Wudker/Solarbank/Hardware/Photos/image-1791736555270.jpg

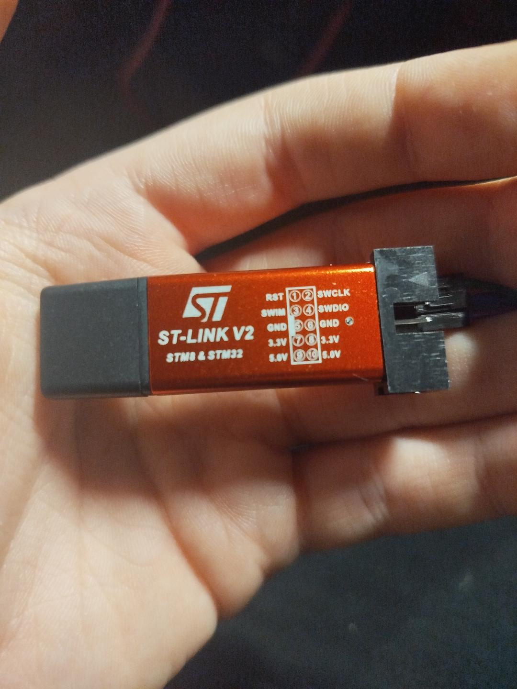
Hardware/Photos/image-1791736555270.jpg
