Wudker/Solarbank/Hardware/PCB/Main.png

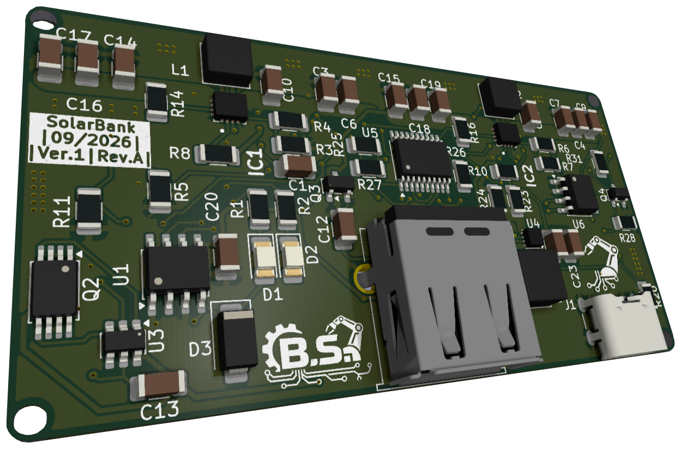
Hardware/PCB/Main.png
