Wudker/Solarbank/Hardware/Model/Main.png

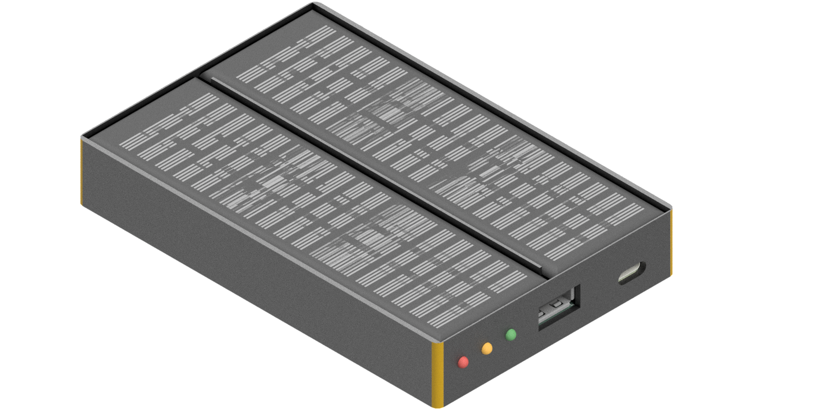
Hardware/Model/Main.png
