Wudker/Solarbank/BOM/BOM.xlsx

Sheet: PCB_BOM
Reference, | Qty | Value | Footprint | Link
C1,C2,C24,C25,C26,C5,C12,C13,C30, | 9 | 100n | Capacitor_SMD:C_1206_3216Metric | https://www.tme.eu/pl/details/cl31b104kbcnnnc/kondensatory-mlcc-smd/samsung/
C3,C4,C6,C7,C9,C21,C22,C23, | 8 | 22u | Capacitor_SMD:C_1206_3216Metric | https://www.tme.eu/pl/details/grm31cr61e226ke15l/kondensatory-mlcc-smd/murata/
C8,C10,C11,C14,C15,C16,C17,C18,C19,C20, | 10 | 10u | Capacitor_SMD:C_1206_3216Metric | https://www.tme.eu/pl/details/cl31a106kahnnne/kondensatory-mlcc-smd/samsung/
C27, | 1 | 4.7u | Capacitor_SMD:C_1206_3216Metric | https://www.tme.eu/pl/details/cl31a475kahnnne/kondensatory-mlcc-smd/samsung/
C28, | 1 | 1u | Capacitor_SMD:C_1206_3216Metric | https://www.tme.eu/pl/details/cl31b105kbhnnne/kondensatory-mlcc-smd/samsung/
C29, | 1 | 10n | Capacitor_SMD:C_1206_3216Metric | https://www.tme.eu/pl/details/cc1206krx7r9bb103/kondensatory-mlcc-smd/yageo/
D1,D2, | 2 | LED | LED_SMD:LED_1206_3216Metric_Pad1.42x1.75mm_HandSolder | https://www.tme.eu/pl/details/of-smd3216r/diody-led-smd-kolorowe/optoflash/
D3,D4, | 2 | SS32 | Diode_SMD:D_SMA | https://www.tme.eu/pl/details/b340a-13-f/diody-schottky-smd/diodes-incorporated
IC1,IC2, | 2 | TPS63070RNMR | KiCad:TPS630701RNMR | https://www.digikey.pl/en/products/detail/texas-instruments/TPS63070RNMR/6217416
J1, | 1 | Alterative_charging | Connector_USB:USB_C_Receptacle_GCT_USB4125-xx-x-0190_6P_TopMnt_Horizontal | https://www.tme.eu/pl/details/usb4125-gf-a-0190/zlacza-usb-i-ieee1394/gct/
J2, | 1 | Vout | Connector_USB:USB_A_Molex_67643_Horizontal | https://www.tme.eu/pl/details/mx-67643-0910/zlacza-usb-i-ieee1394/molex/67643-0910/
L1,L2, | 2 | 1.5uH / XFL4020-152MEC | Inductor_SMD:L_Coilcraft_XAL4020-XXX | https://www.coilcraft.com/en-us/products/power/shielded-inductors/molded-inductor/xfl/xfl4020/?skuId=2392|3785
L3, | 1 | 1u / XEL5030-102 | Inductor_SMD:L_Coilcraft_XAL5030-XXX | https://www.digikey.pl/en/products/detail/texas-instruments/TPS63070RNMR/6217416
Q1,Q3,Q4,Q5, | 4 | 2N7002 | Package_TO_SOT_SMD:SOT-23 | https://www.tme.eu/pl/details/2n7002-dio/tranzystory-z-kanalem-n-smd/diotec-semiconductor/2n7002
Q2, | 1 | 8205A | Package_SO:TSSOP-8_4.4x3mm_P0.65mm | https://pl.aliexpress.com/item/1005006168808626.html
Q6, | 1 | DMP3099L | Package_TO_SOT_SMD:SOT-23 | https://www.tme.eu/pl/details/dmp3099l-7/tranzystory-z-kanalem-p-smd/diodes-incorporated/
R1,R2,R17, | 3 | 1k | Resistor_SMD:R_1206_3216Metric | https://www.tme.eu/pl/details/smd1206-1k-1%25/rezystory-smd/royalohm/1206s4f1001t5e/
R3, | 1 | 680k | Resistor_SMD:R_1206_3216Metric | https://www.tme.eu/pl/details/rc1206fr-07680kl/rezystory-smd/yageo/?expanded=true
R4, | 1 | 130k | Resistor_SMD:R_1206_3216Metric | https://www.tme.eu/pl/details/smd1206-130k/rezystory-smd/royalohm/1206s4j0134t5e/
R5,R11,R14,R16,R22,R28,R29,R30, | 8 | 10k | Resistor_SMD:R_1206_3216Metric | https://www.tme.eu/pl/details/rc1206fr-0710k/rezystory-smd/yageo/rc1206fr-0710kl/
R6, | 1 | 470k | Resistor_SMD:R_1206_3216Metric | https://www.tme.eu/pl/details/rc1206fr-07470k/rezystory-smd/yageo/rc1206fr-07470kl/
R7, | 1 | 150k | Resistor_SMD:R_1206_3216Metric | https://www.tme.eu/pl/details/wr12x1503ftl/rezystory-smd/walsin/
R8,R10,R24, | 3 | 100k | Resistor_SMD:R_1206_3216Metric | https://www.tme.eu/pl/details/smd1206-100k/rezystory-smd/royalohm/1206s4j0104t5e/
R9, | 1 | 1.5k | Resistor_SMD:R_1206_3216Metric | https://www.tme.eu/pl/details/rc1206fr-071k5/rezystory-smd/yageo/rc1206fr-071k5l/
R12, | 1 | 220k | Resistor_SMD:R_1206_3216Metric | https://www.tme.eu/pl/details/rc1206fr-07220kl/rezystory-smd/yageo/
R13, | 1 | 330k | Resistor_SMD:R_1206_3216Metric | https://www.tme.eu/pl/details/rc1206fr-07330kl/rezystory-smd/yageo/
R15, | 1 | 100 | Resistor_SMD:R_1206_3216Metric | https://www.tme.eu/pl/details/rc1206fr-07100r/rezystory-smd/yageo/rc1206fr-07100rl/
R18,R21, | 2 | 5.1k | Resistor_SMD:R_1206_3216Metric | https://www.tme.eu/pl/details/crcw12065k10fktabc/rezystory-smd/vishay/
R19, | 1 | 22k | Resistor_SMD:R_1206_3216Metric | https://www.tme.eu/pl/details/rc1206fr-0722k/rezystory-smd/yageo/rc1206fr-0722kl/
R20, | 1 | 33k | Resistor_SMD:R_1206_3216Metric | https://www.tme.eu/pl/details/wr12x3302ftl/rezystory-smd/walsin/
R23, | 1 | 732k | Resistor_SMD:R_1206_3216Metric
R25,R26,R27, | 3 | 4.7k | Resistor_SMD:R_1206_3216Metric | https://www.tme.eu/pl/details/rc1206fr-074k7/rezystory-smd/yageo/rc1206fr-074k7l/
R31, | 1 | 0.05 | Resistor_SMD:R_1206_3216Metric | https://www.tme.eu/pl/details/mbr1206b5fr050s/rezystory-smd/wayon/
U1, | 1 | TP4056-42-ESOP8 | Package_SO:SOIC-8-1EP_3.9x4.9mm_P1.27mm_EP2.41x3.3mm_ThermalVias | https://allegro.pl/produkt/tp4056-4056-4056e-sop-8-5v-1a-battery-charge-controller-9f4e096b-2b10-4130-90a1-40e4469a7fbb?offerId=17285593534
U2, | 1 | MCP4018-10k | Package_TO_SOT_SMD:SOT-363_SC-70-6 | https://www.mouser.pl/pl/ProductDetail/Microchip-Technology/MCP4018T-103E-LTY?qs=savM97goi5hGuILh2wIQ1w%3D%3D
U3, | 1 | DW01A | Package_TO_SOT_SMD:SOT-23-6 | https://pl.aliexpress.com/item/1005006168808626.html
U4, | 1 | TPS61022 | Package_DFN_QFN:Texas_RWU0007A_VQFN-7_2x2mm_P0.5mm | https://www.mouser.pl/pl/ProductDetail/Texas-Instruments/TPS61022RWUT?qs=vLWxofP3U2xU7G%2FuAQNIxA%3D%3D
U5, | 1 | STM32U031F8Px | Package_SO:TSSOP-20_4.4x6.5mm_P0.65mm | https://www.tme.eu/pl/details/stm32u031f8p6/mikrokontrolery-st/stmicroelectronics/
U6, | 1 | INA219AxD | Package_SO:SOIC-8_3.9x4.9mm_P1.27mm | https://www.tme.eu/pl/details/ina219aidr/wzmacniacze-operacyjne-smd/texas-instruments/

Sheet: Other_elements
Name | Qty | Link
Indicators LED
Greeen | 1 | https://www.tme.eu/pl/details/ltl17kcgm4j/diody-led-tht-okragle/liteon/
Orange | 1 | https://www.tme.eu/pl/details/oso5ja3162a/diody-led-tht-okragle/optosupply/
Red | 1 | https://www.tme.eu/pl/details/osr5ja3162a/diody-led-tht-okragle/optosupply/
Button | 1 | https://www.tme.eu/pl/details/tact-67n-f/mikroprzelaczniki-tact/ninigi/
Fotopanels | 2 | https://sklep.msalamon.pl/produkt/panel-sloneczny-120x38mm-6v-100ma-06w/
Cell | 1 | https://botland.com.pl/akumulatory-li-pol-1s-37v/15643-akumulator-li-pol-akyga-3500mah-1s-37v-zlacze-jst-bec-gniazdo-68x55x6mm-5904422324438.html
M2 heatset inserts & bolts | 4 | https://www.ruthex.de/en/products/ruthex-gewindeeinsatz-m2-70-stuck-rx-m2x4-messing-gewindebuchsen
 |  | https://rc-team.pl/wszystkie-czesci-maverick/144486-maverick-sruby-m2x15mm-countersunk-screw-5700135347456-534745.html
