Wudker/Solarbank/BOM/TME_ORDER.csv

Symbol klienta | Symbol | Oznaczenie producenta | Producent | Ilość | Jednostka | Cena netto | Cena brutto | Wartość netto | Wartość brutto | Waluta
 | CL21B105KAFNNNE | CL21B105KAFNNNE | SAMSUNG | 10 | szt | 0.26 | 0.3199 | 2.6 | 3.2 | PLN
 | B340A-13-F | B340A-13-F | DIODES INCORPORATED | 2 | szt | 1.93 | 2.3727 | 3.86 | 4.75 | PLN
 | USB4125-GF-A-0190 | USB4125-GF-A-0190 | GCT | 2 | szt | 2.155 | 2.6507 | 4.31 | 5.3 | PLN
 | 2N7002-DIO | 2N7002 | DIOTEC SEMICONDUCTOR | 10 | szt | 0.31 | 0.3806 | 3.1 | 3.81 | PLN
 | DMP3099L-7 | DMP3099L-7 | DIODES INCORPORATED | 10 | szt | 0.815 | 1.002 | 8.15 | 10.02 | PLN
 | RC1206JR-07680K | RC1206JR-07680KL | YAGEO | 10 | szt | 0.027 | 0.03284 | 0.27 | 0.33 | PLN
 | SMD1206-130K | 1206S4J0134T5E | ROYALOHM | 100 | szt | 0.045 | 0.05535 | 4.5 | 5.54 | PLN
 | RC1206FR-07470K | RC1206FR-07470KL | YAGEO | 5 | szt | 0.37 | 0.4535 | 1.85 | 2.27 | PLN
 | WR12X1503FTL | WR12X1503FTL | WALSIN | 10 | szt | 0.106 | 0.12967 | 1.06 | 1.3 | PLN
 | SMD1206-100K | 1206S4J0104T5E | ROYALOHM | 100 | szt | 0.065 | 0.07993 | 6.5 | 7.99 | PLN
 | INA219AIDR | INA219AIDR | TEXAS INSTRUMENTS | 2 | szt | 6.55 | 8.0565 | 13.1 | 16.11 | PLN
 | STM32U031F8P6 | STM32U031F8P6 | STMicroelectronics | 2 | szt | 9.115 | 11.2176 | 18.23 | 22.44 | PLN
 | MBR1206B5FR050S | MBR1206B5FR050S | WAYON | 5 | szt | 0.43 | 0.5282 | 2.15 | 2.64 | PLN
 | WR12X3302FTL | WR12X3302FTL | WALSIN | 5 | szt | 0.31 | 0.38212 | 1.55 | 1.91 | PLN
 | RC1206FR-0722K | RC1206FR-0722KL | YAGEO | 10 | szt | 0.056 | 0.06908 | 0.56 | 0.69 | PLN
 | RC1206FR-07100R | RC1206FR-07100RL | YAGEO | 10 | szt | 0.048 | 0.05904 | 0.48 | 0.59 | PLN
 | RC1206FR-07330KL | RC1206FR-07330KL | YAGEO | 10 | szt | 0.048 | 0.05871 | 0.48 | 0.59 | PLN
 | RC1206FR-07220KL | RC1206FR-07220KL | YAGEO | 10 | szt | 0.064 | 0.07921 | 0.64 | 0.79 | PLN
 | RC1206FR-071K5 | RC1206FR-071K5L | YAGEO | 10 | szt | 0.067 | 0.08157 | 0.67 | 0.82 | PLN
 | OSO5JA3162A | OSO5JA3162A | OPTOSUPPLY | 5 | szt | 0.65 | 0.7993 | 3.25 | 4 | PLN
 | LTL17KCGM4J | LTL17KCGM4J | LITEON | 3 | szt | 1.0633 | 1.3075 | 3.19 | 3.92 | PLN
