Wudker/Solarbank/Hardware/Model/SLT/Bottom.stl

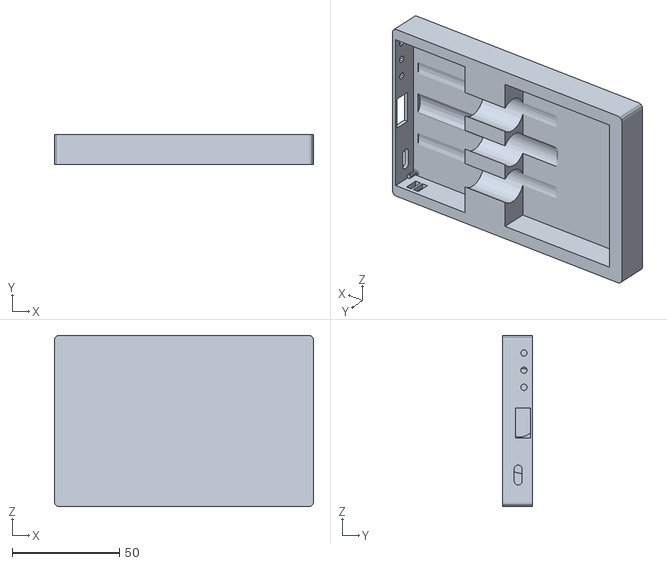
[picture p4: CAD file, 2026-09-20]
Hardware/Model/SLT/Bottom.stl
121.0 x 14.0 x 80.0
