Wudker/Solarbank/Hardware/Model/Parts/OscarML_Led 3mm Rojo v1.step

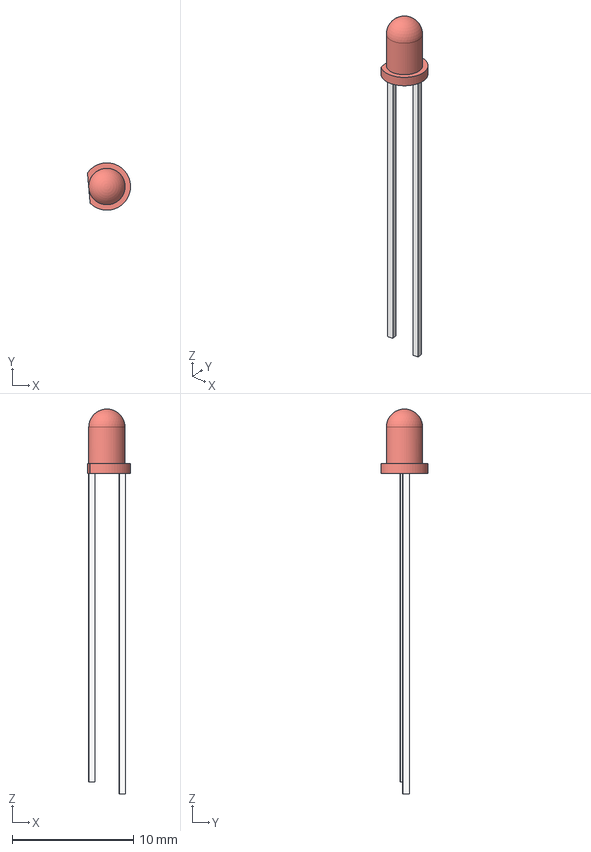
[picture p5: CAD file, 2026-09-19]
Hardware/Model/Parts/OscarML_Led 3mm Rojo v1.step
3.55 x 3.90 x 31.7 mm
