Wudker/Solarbank/Hardware/Model/Parts/SolarPanel_30x65x3mm.step

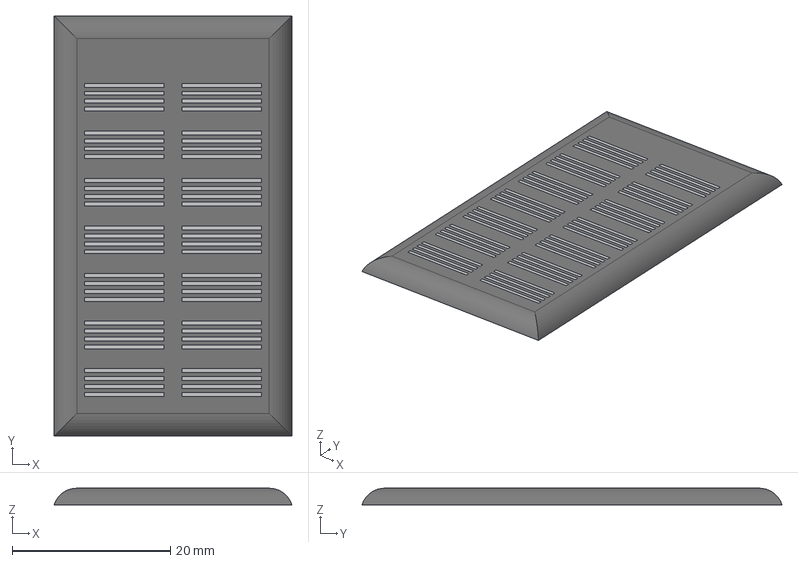
[picture p6: CAD file, 2026-09-19]
Hardware/Model/Parts/SolarPanel_30x65x3mm.step
30.0 x 53.0 x 2.10 mm
