Wudker/Solarbank/Hardware/Model/Parts/Micro_Button_6x6.STEP

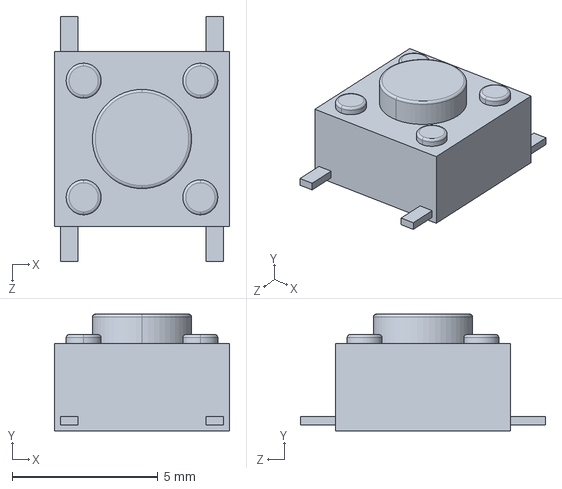
[picture p7: CAD file, 2026-09-19]
Hardware/Model/Parts/Micro_Button_6x6.STEP
6.00 x 4.00 x 8.40 mm
