Wudker/Solarbank/Hardware/Model/Parts/led 3 mm amarillo.step

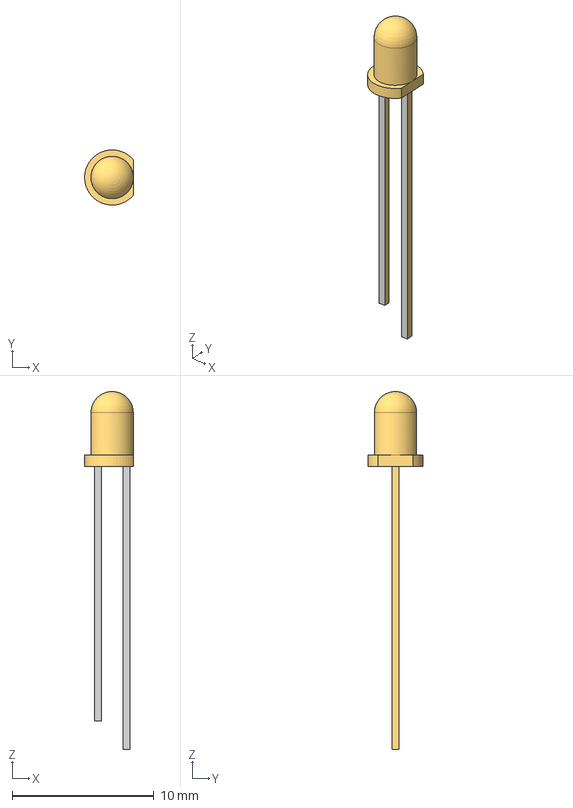
[picture p8: CAD file, 2026-09-19]
Hardware/Model/Parts/led 3 mm amarillo.step
3.45 x 3.90 x 25.3 mm
