Wudker/Solarbank/Hardware/Model/Parts/94459A767_Heat-Set Inserts for Plastic.STEP

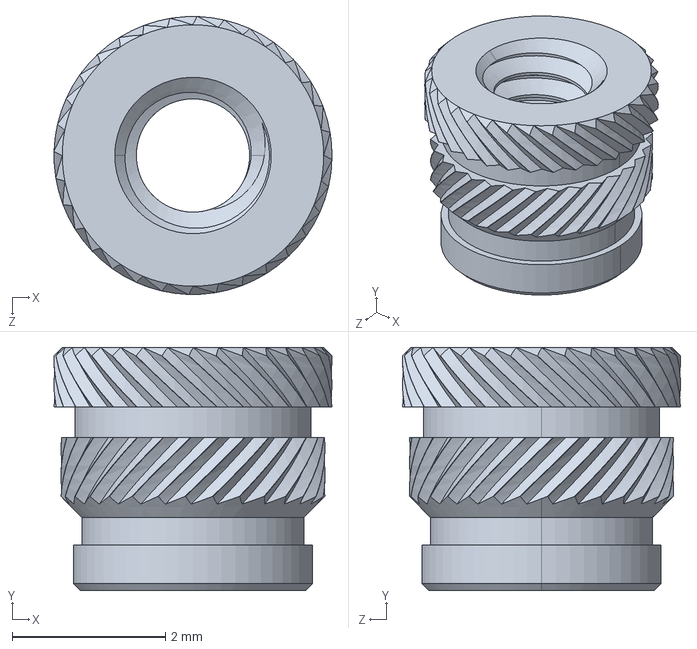
[picture p9: CAD file, 2026-09-20]
Hardware/Model/Parts/94459A767_Heat-Set Inserts for Plastic.STEP
3.63 x 3.18 x 3.63 mm
