Wudker/Solarbank/Hardware/PCB/Power_bank_PCB/TPS61022RWUR/3D/TPS61022RWUR.stp

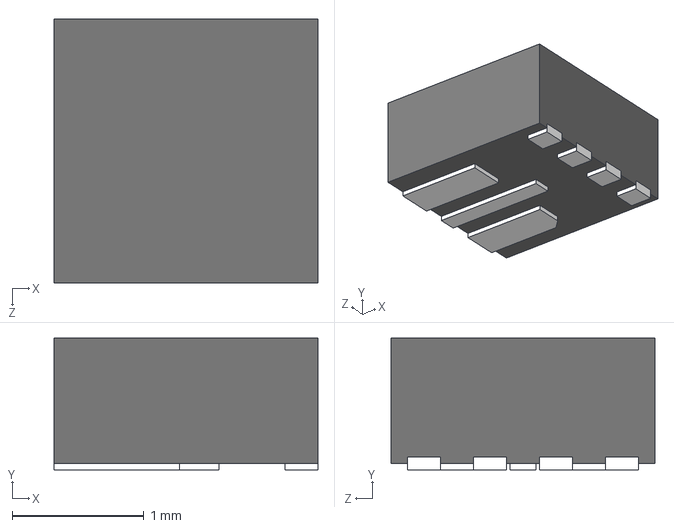
[picture p10: CAD file, 2026-09-09]
Hardware/PCB/Power_bank_PCB/TPS61022RWUR/3D/TPS61022RWUR.stp
2.00 x 1.00 x 2.00 mm
