Wudker/Solarbank/Hardware/PCB/Power_bank_PCB/TPS63070RNMR/3D/TPS63070RNMR.stp

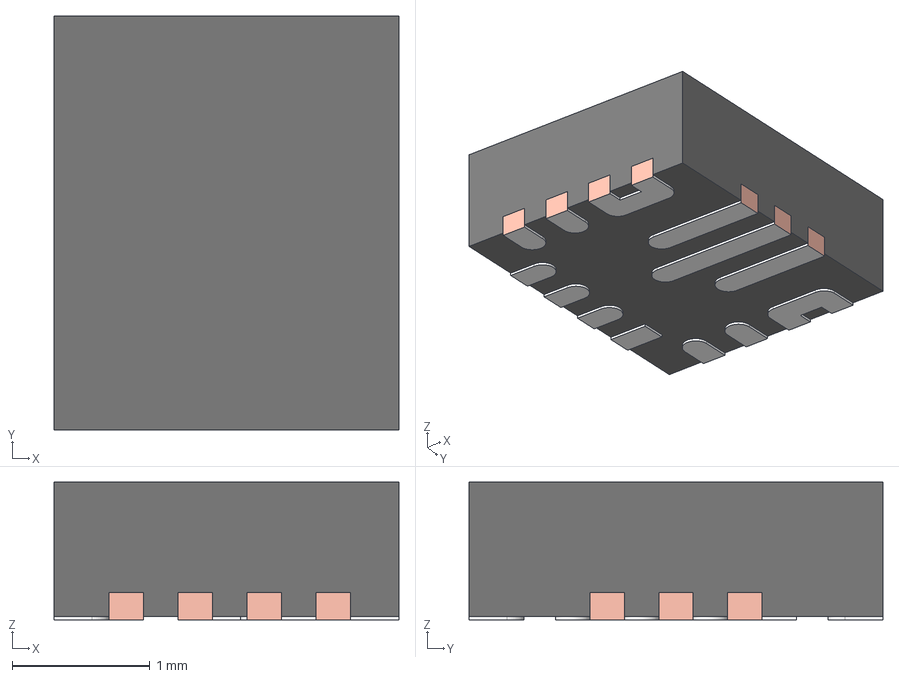
[picture p11: CAD file, 2026-09-02]
Hardware/PCB/Power_bank_PCB/TPS63070RNMR/3D/TPS63070RNMR.stp
2.50 x 3.00 x 1.00 mm
FRAME-RNM0015A
BODY-QFN
PIN1-ID
