Wudker/Solarbank/Hardware/Model/Parts/92000A022_Passivated 18-8 Stainless Steel Pan Head Phillips Screws.STEP

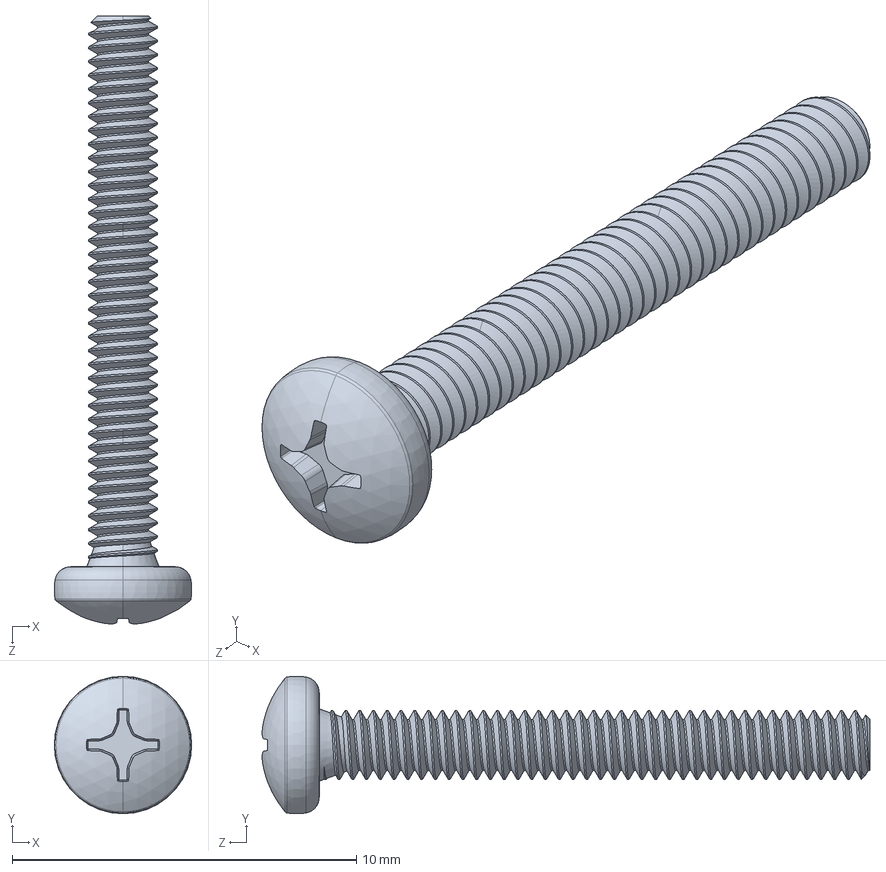
[picture p12: CAD file, 2026-09-20]
Hardware/Model/Parts/92000A022_Passivated 18-8 Stainless Steel Pan Head Phillips Screws.STEP
3.99 x 3.99 x 17.7 mm
