Wudker/Solarbank/(list of files, cad)

Other CAD files:
Hardware/Model/Parts/OscarML_Led 3mm Verde.step
Hardware/Model/Main.iam
Hardware/Model/Parts/92000A022_Passivated 18-8 Stainless Steel Pan Head Phillips Screws/92000A022_Passivated 18-8 Stainless Steel Pan Head Phillips Screws.ipt
Hardware/Model/Parts/94459A767_Heat-Set Inserts for Plastic/94459A767_Heat-Set Inserts for Plastic.ipt
Hardware/Model/Parts/Battery_prop.ipt
Hardware/Model/Parts/Bottom.ipt
Hardware/Model/Parts/Micro_Button_6x6/Micro_Button_6x6.ipt
Hardware/Model/Parts/OscarML_Led 3mm Rojo v1/OscarML_Led 3mm Rojo v1.ipt
Hardware/Model/Parts/OscarML_Led 3mm Verde/OscarML_Led 3mm Verde.ipt
Hardware/Model/Parts/SolarPanel_30x65x3mm/SolarPanel_30x65x3mm.ipt
Hardware/Model/Parts/Top_part.ipt
Hardware/Model/Parts/led 3 mm amarillo/led 3 mm amarillo.ipt
Hardware/PCB/Power_bank_PCB/PCB/PCB/PCB.ipt
