Wudker/Solarbank/Hardware/PCB/Power_bank_PCB/Power_bank_PCB.kicad_pcb

## KiCad design Hardware/PCB/Power_bank_PCB/Power_bank_PCB.kicad_pcb (2026-09-09)

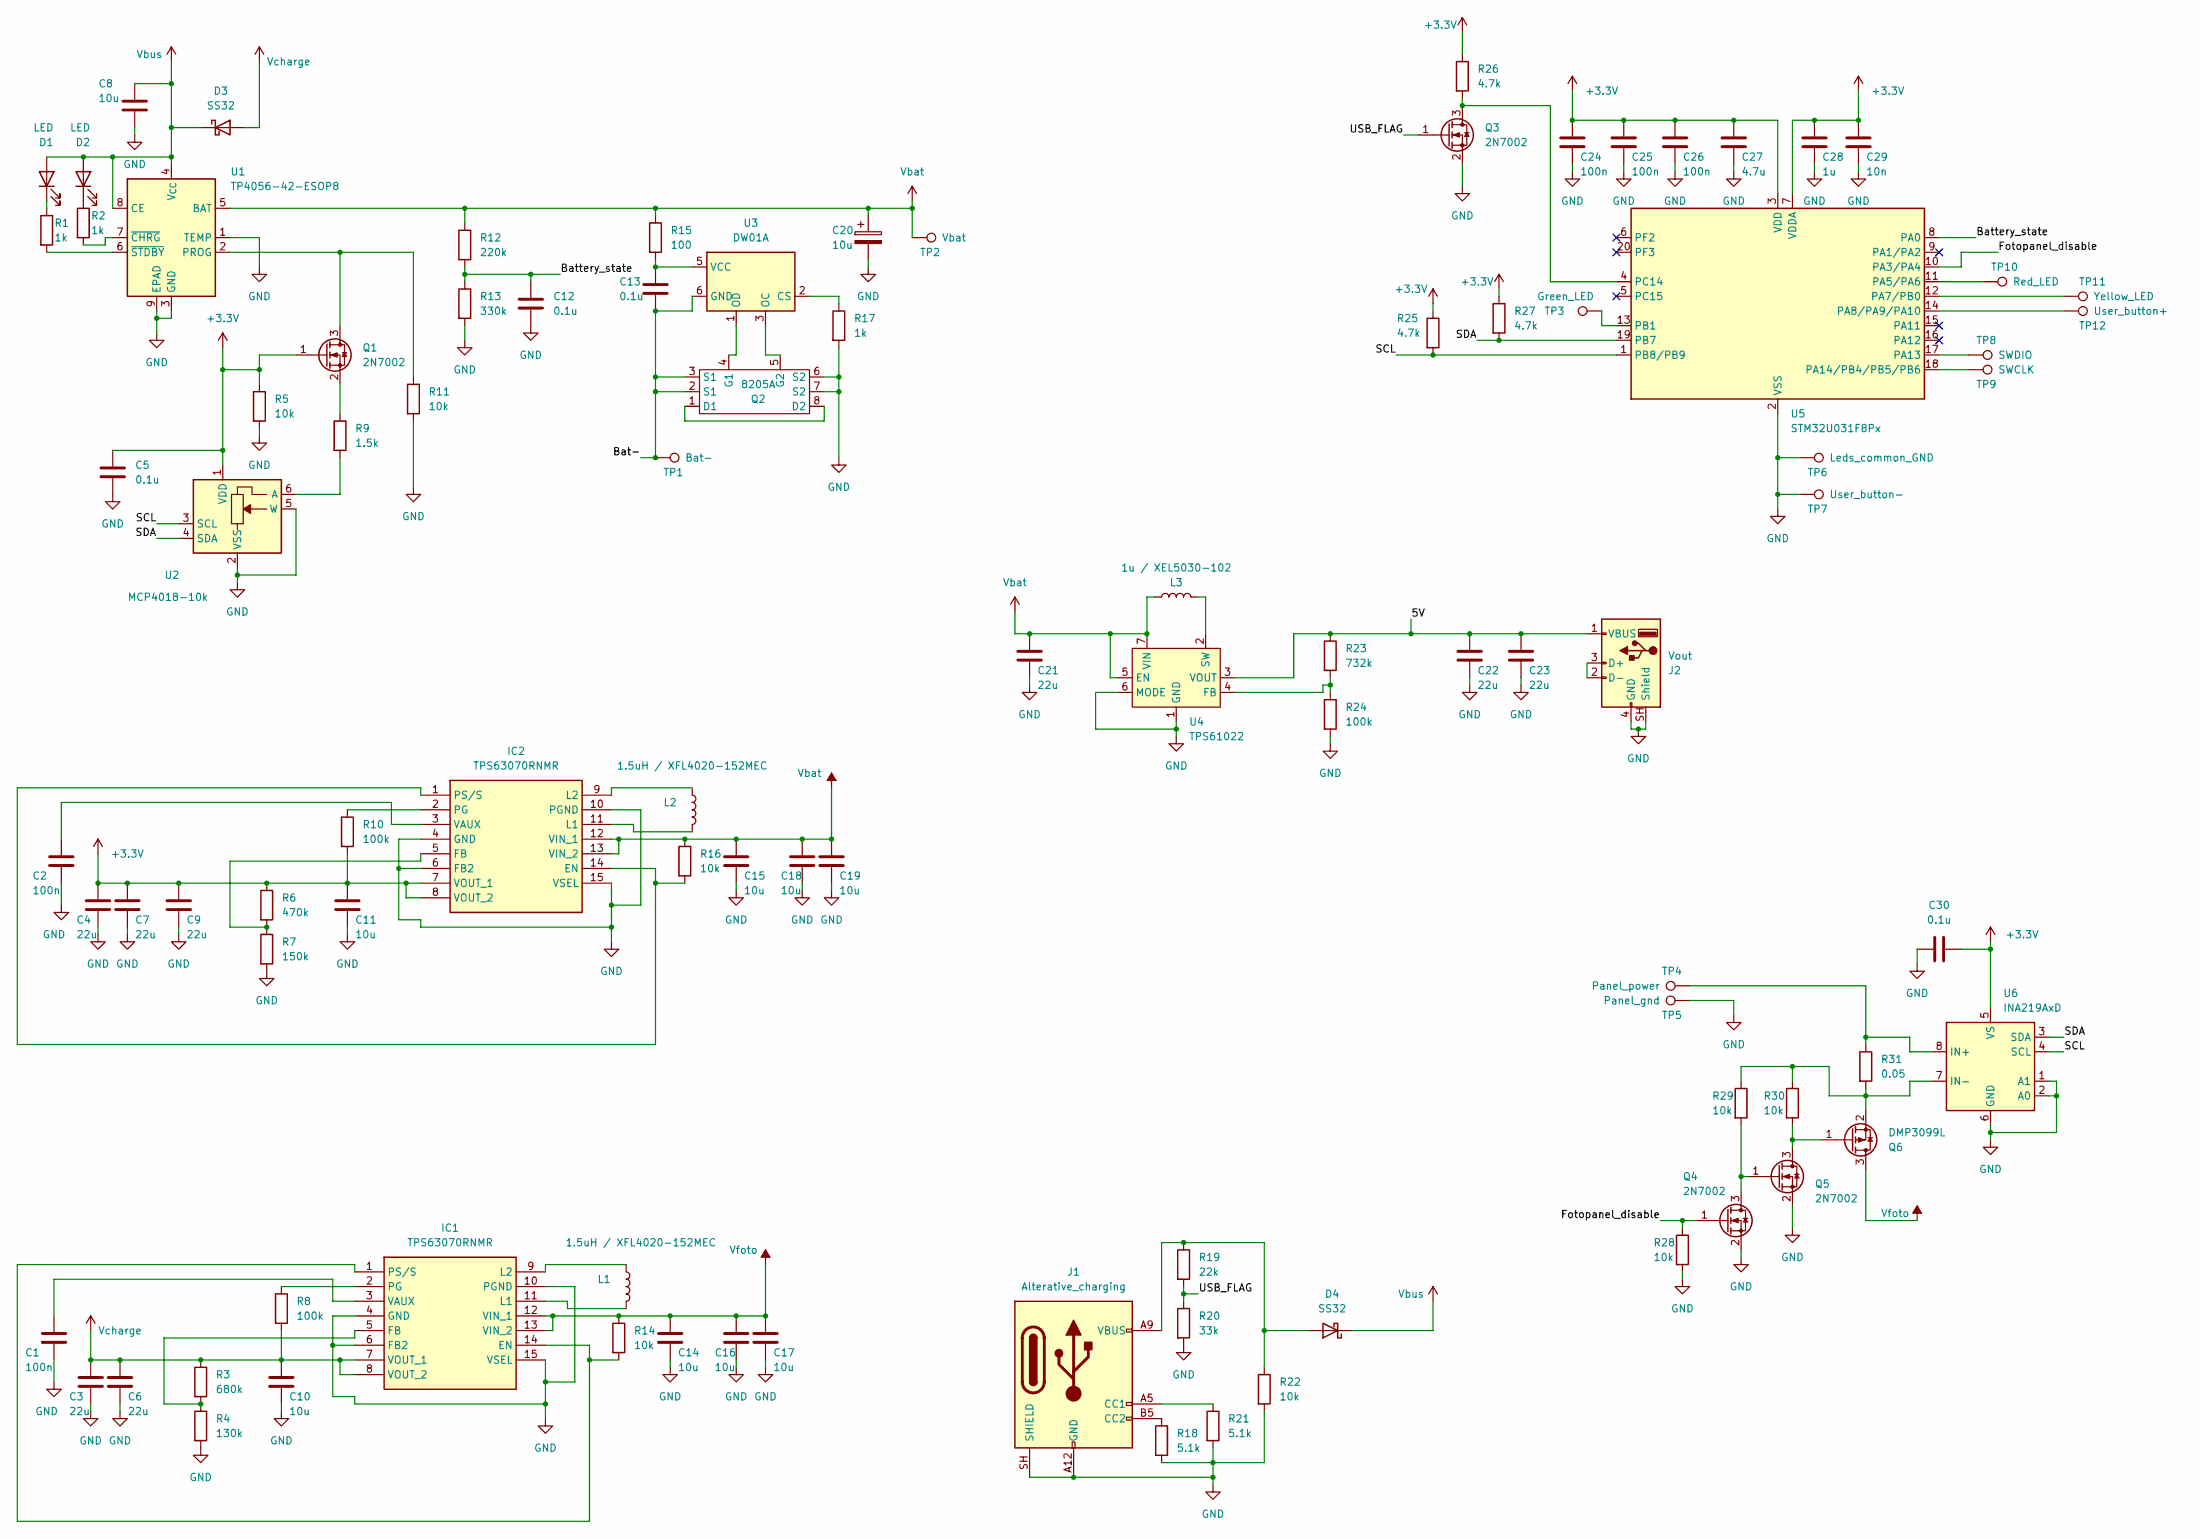
[picture p13: schematic Power_bank_PCB.kicad_sch, SolarBank]

Parts:
C1, C2, C24, C25, C26: 100n; C_1206_3216Metric
C3, C4, C6, C7, C9, C21, C22, C23: 22u; C_1206_3216Metric
C5, C12, C13, C30: 0.1u; C_1206_3216Metric
C8, C10, C11, C14, C15, C16, C17, C18, C19, C20: 10u; C_1206_3216Metric
C27: 4.7u; C_1206_3216Metric
C28: 1u; C_1206_3216Metric
C29: 10n; C_1206_3216Metric
D1, D2: LED; LED_1206_3216Metric_Pad1.42x1.75mm_HandSolder
D3, D4: SS32; D_SMA
IC1, IC2: TPS63070RNMR; TPS630701RNMR; Manufacturer_Part_Number TPS63070RNMR
J1: Alterative_charging; USB_C_Receptacle_GCT_USB4125-xx-x-0190_6P_TopMnt_Horizontal
J2: Vout; USB_A_Molex_67643_Horizontal
L1, L2: 1.5uH / XFL4020-152MEC; L_Coilcraft_XAL4020-XXX
L3: 1u / XEL5030-102; L_Coilcraft_XAL5030-XXX
Q1, Q3, Q4, Q5: 2N7002; SOT-23
Q2: 8205A; TSSOP-8_4.4x3mm_P0.65mm
Q6: DMP3099L; SOT-23
R1, R2, R17: 1k; R_1206_3216Metric
R3: 680k; R_1206_3216Metric
R4: 130k; R_1206_3216Metric
R5, R11, R14, R16, R22, R28, R29, R30: 10k; R_1206_3216Metric
R6: 470k; R_1206_3216Metric
R7: 150k; R_1206_3216Metric
R8, R10, R24: 100k; R_1206_3216Metric
R9: 1.5k; R_1206_3216Metric
R12: 220k; R_1206_3216Metric
R13: 330k; R_1206_3216Metric
R15: 100; R_1206_3216Metric
R18, R21: 5.1k; R_1206_3216Metric
R19: 22k; R_1206_3216Metric
R20: 33k; R_1206_3216Metric
R23: 732k; R_1206_3216Metric
R25, R26, R27: 4.7k; R_1206_3216Metric
R31: 0.05; R_1206_3216Metric
TP1: Bat-; TestPoint_Pad_D2.0mm
TP2: Vbat; TestPoint_Pad_D2.0mm
TP3: Green_LED; TestPoint_Pad_D2.0mm
TP4: Panel_power; TestPoint_Pad_D2.0mm
TP5: Panel_gnd; TestPoint_Pad_D2.0mm
TP6: Leds_common_GND; TestPoint_Pad_D2.0mm
TP7: User_button-; TestPoint_Pad_D2.0mm
TP8: SWDIO; TestPoint_Pad_D2.0mm
TP9: SWCLK; TestPoint_Pad_D2.0mm
TP10: Red_LED; TestPoint_Pad_D2.0mm
TP11: Yellow_LED; TestPoint_Pad_D2.0mm
TP12: User_button+; TestPoint_Pad_D2.0mm
U1: TP4056-42-ESOP8; SOIC-8-1EP_3.9x4.9mm_P1.27mm_EP2.41x3.3mm_ThermalVias
U2: MCP4018-10k; SOT-363_SC-70-6
U3: DW01A; SOT-23-6
U4: TPS61022; Texas_RWU0007A_VQFN-7_2x2mm_P0.5mm
U5: STM32U031F8Px; TSSOP-20_4.4x6.5mm_P0.65mm
U6: INA219AxD; SOIC-8_3.9x4.9mm_P1.27mm

Connections:
+3.3V: C4.2, C5.1, C7.2, C9.2, C11.2, C24.2, C25.2, C26.2, C27.2, C28.2, C29.2, C30.2, IC2.7 (VOUT_1), IC2.8 (VOUT_2), Q1.1 (G), R5.1, R6.1, R10.2, R25.1, R26.1, R27.1, U2.1 (VDD), U5.3 (VDD), U5.7 (VDDA), U6.5 (VS)
/5V: C22.2, C23.2, J2.1 (VBUS), R23.1, U4.3 (VOUT)
/Bat-: C13.1, Q2.2 (S1), Q2.3 (S1), TP1.1 (1_1), U3.6 (GND)
/Battery_state: C12.1, R12.2, R13.1, U5.8 (PA0)
/Fotopanel_disable: Q4.1 (G), R28.1, U5.10 (PA3/PA4)
/SCL: R25.2, U2.3 (SCL), U5.1 (PB8/PB9), U6.4 (SCL)
/SDA: R27.2, U2.4 (SDA), U5.19 (PB7), U6.3 (SDA)
/USB_FLAG: Q3.1 (G), R19.2, R20.1
GND: C1.1, C2.1, C3.1, C4.1, C5.2, C6.1, C7.1, C8.2, C9.1, C10.1, C11.1, C12.2, C14.1, C15.1, C16.1, C17.1, C18.1, C19.1, C20.2, C21.1, C22.1, C23.1, C24.1, C25.1, C26.1, C27.1, C28.1, C29.1, C30.1, IC1.4 (GND), IC1.6 (FB2), IC1.10 (PGND), IC1.15 (VSEL), IC2.4 (GND), IC2.6 (FB2), IC2.10 (PGND), IC2.15 (VSEL), J1.A12 (GND), J1.B12 (GND), J1.SH (SHIELD), J2.4 (GND), J2.SH (Shield), Q2.6 (S2), Q2.7 (S2), Q3.2 (S), Q4.2 (S), Q5.2 (S), R4.2, R5.2, R7.2, R11.2, R13.2, R17.2, R18.2, R20.2, R21.2, R22.2, R24.2, R28.2, TP5.1 (1_1), TP6.1 (1_1), TP7.1 (1_1), U1.1 (TEMP), U1.3 (GND), U1.9 (EPAD), U2.2 (VSS), U2.5 (W), U4.1 (GND), U4.6 (MODE), U5.2 (VSS), U6.1 (A1), U6.2 (A0), U6.6 (GND)
unnamed: D1.1 (K), R1.1
unnamed: D2.1 (K), R2.1
unnamed: D4.2 (A), J1.A9 (VBUS), J1.B9 (VBUS), R19.1, R22.1
unnamed: IC1.1 (PS/S), IC1.14 (EN), R14.2
unnamed: IC1.5 (FB), R3.2, R4.1
unnamed: IC1.11 (L1), L1.2
unnamed: IC1.9 (L2), L1.1
unnamed: IC1.2 (PG), R8.1
unnamed: C1.2, IC1.3 (VAUX)
unnamed: IC2.1 (PS/S), IC2.14 (EN), R16.2
unnamed: IC2.5 (FB), R6.2, R7.1
unnamed: IC2.11 (L1), L2.2
unnamed: IC2.9 (L2), L2.1
unnamed: IC2.2 (PG), R10.1
unnamed: C2.2, IC2.3 (VAUX)
unnamed: J1.A5 (CC1), R21.1
unnamed: J1.B5 (CC2), R18.1
unnamed: J2.2 (D-), J2.3 (D+)
unnamed: Q1.3 (D), R11.1, U1.2 (PROG)
unnamed: Q1.2 (S), R9.1
unnamed: Q2.1 (D1), Q2.8 (D2)
unnamed: Q2.4 (G1), U3.1 (OD)
unnamed: Q2.5 (G2), U3.3 (OC)
unnamed: Q3.3 (D), R26.2, U5.4 (PC14)
unnamed: Q4.3 (D), Q5.1 (G), R29.2
unnamed: Q5.3 (D), Q6.1 (G), R30.2
unnamed: Q6.2 (S), R29.1, R30.1, R31.2, U6.7 (IN-)
unnamed: R2.2, U1.7 (~CHRG)
unnamed: R1.2, U1.6 (~STDBY)
unnamed: R9.2, U2.6 (A)
unnamed: R17.1, U3.2 (CS)
unnamed: C13.2, R15.2, U3.5 (VCC)
unnamed: R23.2, R24.1, U4.4 (FB)
unnamed: L3.2, U4.2 (SW)
unnamed: TP10.1 (1_1), U5.11 (PA5/PA6)
unnamed: TP11.1 (1_1), U5.12 (PA7/PB0)
unnamed: TP12.1 (1_1), U5.14 (PA8/PA9/PA10)
unnamed: TP8.1 (1_1), U5.17 (PA13)
unnamed: TP9.1 (1_1), U5.18 (PA14/PB4/PB5/PB6)
unnamed: TP3.1 (1_1), U5.13 (PB1)
unnamed: R31.1, TP4.1 (1_1), U6.8 (IN+)
Vbat: C15.2, C18.2, C19.2, C20.1, C21.2, IC2.12 (VIN_1), IC2.13 (VIN_2), L3.1, R12.1, R15.1, R16.1, TP2.1 (1_1), U1.5 (BAT), U4.5 (EN), U4.7 (VIN)
Vbus: C8.1, D1.2 (A), D2.2 (A), D3.1 (K), D4.1 (K), U1.4 (V_{CC}), U1.8 (CE)
Vcharge: C3.2, C6.2, C10.2, D3.2 (A), IC1.7 (VOUT_1), IC1.8 (VOUT_2), R3.1, R8.2
Vfoto: C14.2, C16.2, C17.2, IC1.12 (VIN_1), IC1.13 (VIN_2), Q6.3 (D), R14.1

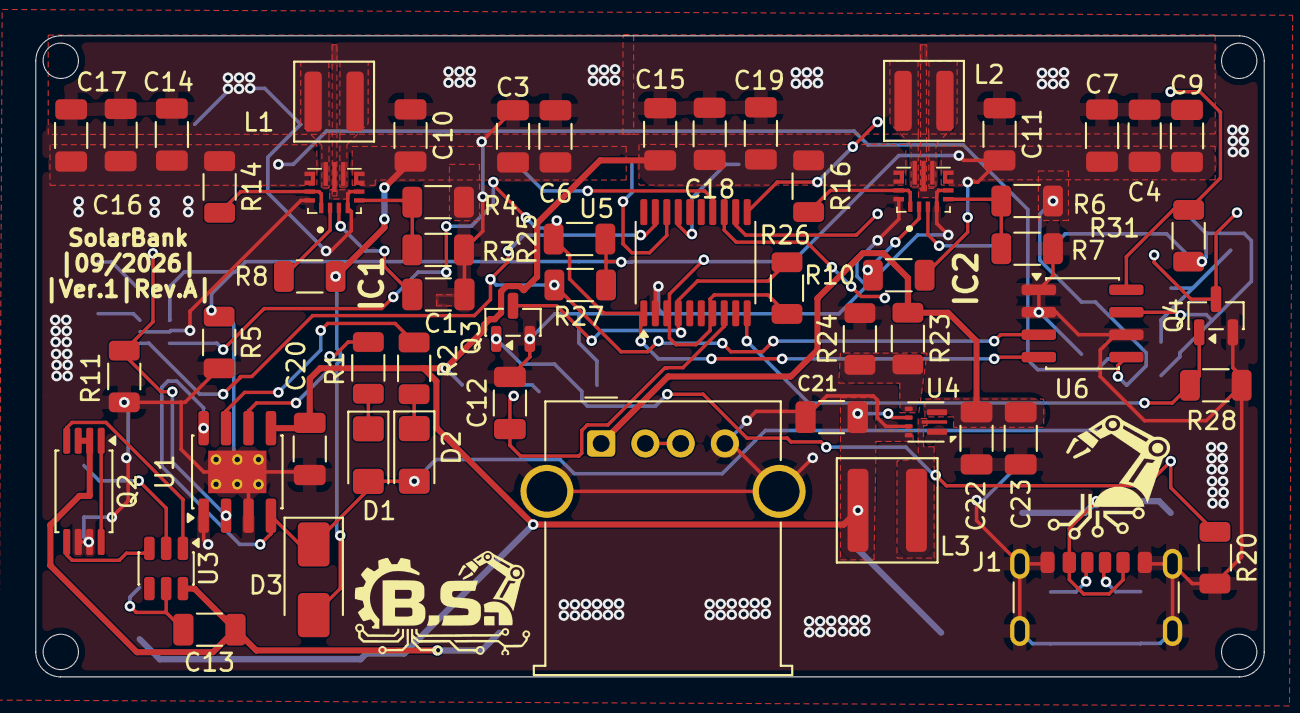
[picture p14: board Power_bank_PCB.kicad_pcb from above]

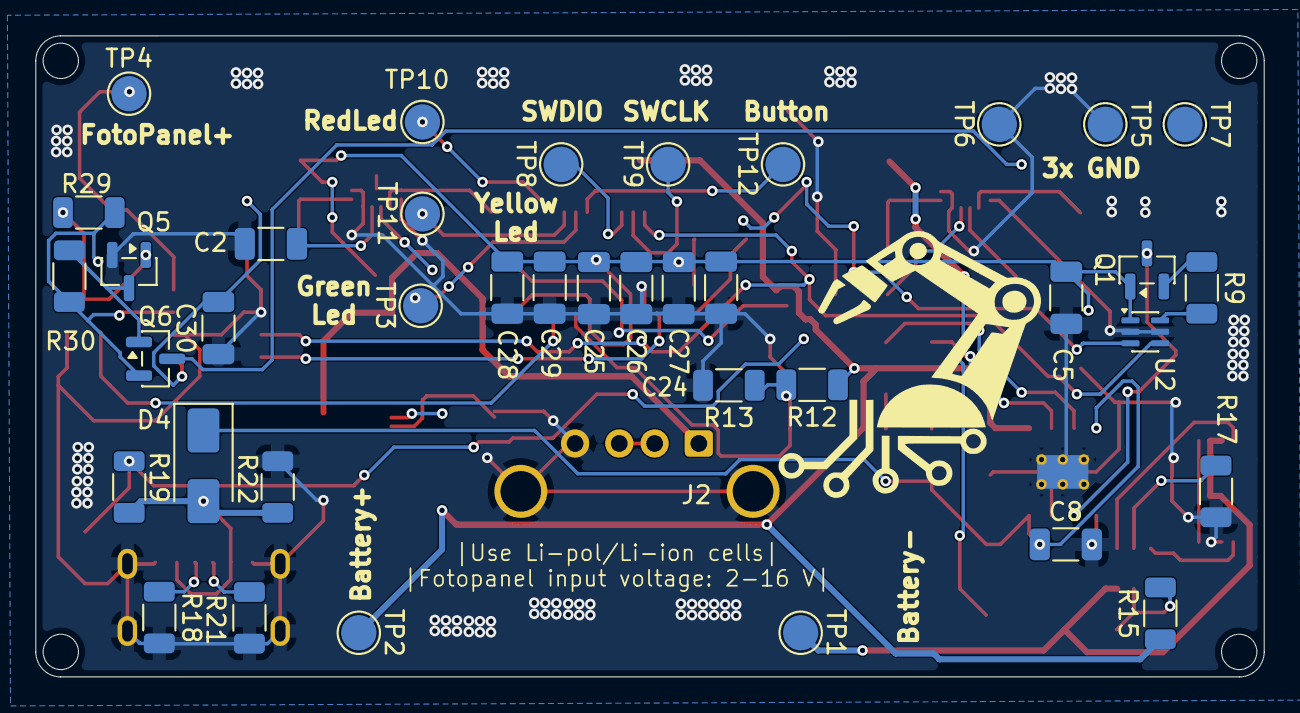
[picture p15: board Power_bank_PCB.kicad_pcb from below]

Board: 2 copper layers, 69.5 x 36.3 mm, 96 parts (38 on the bottom side), 54 nets.
