Wudker/Solarbank/Software/Solar_bank/Solar_bank.ioc

Mcu.UserName=STM32U031F8Px
PA0-CK_IN.GPIO_Label=Battery_state
PA0-CK_IN.Signal=ADC1_IN4
PA3.GPIO_Label=Fotopanel_enable
PA3.Signal=GPIO_Output
PA6.GPIO_Label=LED_status_red
PA6.Signal=GPIO_Output
PA7.GPIO_Label=LED_status_orange
PA7.Signal=GPIO_Output
PA8.GPIO_Label=User_button_input
PA8.Signal=GPXTI8
PB1.GPIO_Label=LED_status_green
PB1.Signal=GPIO_Output
PB7.Signal=I2C1_SDA
PB8.Signal=I2C1_SCL
PC14-OSC32_IN.GPIO_Label=USB_input
PC14-OSC32_IN.Signal=GPIO_Input
