Wudker/Solarbank/Software/Solar_bank/Core/Inc/main.h

#define Battery_state_Pin GPIO_PIN_0
#define Battery_state_GPIO_Port GPIOA
#define Fotopanel_enable_Pin GPIO_PIN_3
#define Fotopanel_enable_GPIO_Port GPIOA
#define LED_status_red_Pin GPIO_PIN_6
#define LED_status_red_GPIO_Port GPIOA
#define LED_status_orange_Pin GPIO_PIN_7
#define LED_status_orange_GPIO_Port GPIOA
#define LED_status_green_Pin GPIO_PIN_1
#define LED_status_green_GPIO_Port GPIOB
#define User_button_input_Pin GPIO_PIN_8
#define User_button_input_GPIO_Port GPIOA
#define USB_input_Pin GPIO_PIN_14
#define USB_input_GPIO_Port GPIOC
