Wudker/Solarbank/(commit log)

2026-08-30 Add battery protection and control schematic
    Adds the custom 8205A MOSFET symbol and KiCad project metadata generated by the PCB editor, plus updates to the Power_bank_PCB schematic with the battery charger, protection, switching, MCU, and INA219 monitoring blocks. Also includes backup ZIPs and lockfile cleanup for the project.
    [Power_bank_PCB.kicad_sch]
2026-08-31 Update of BMS, not finished
    [Power_bank_PCB.kicad_sch]
2026-09-01 Update of schematic
    [Power_bank_PCB.kicad_sch]
2026-09-02 Finishing schematic
    [Power_bank_PCB.kicad_pcb, Power_bank_PCB.kicad_sch, TPS63070RNMR.stp]
2026-09-02 Added two USB, as power output and alternative power input
    [Power_bank_PCB.kicad_sch]
2026-09-02 Add R25/R26, USB_FLAG label and power symbol
    Update KiCad schematic and project to add two resistors (R25, R26), a new power net symbol (#PWR062), USB_FLAG labels, and related wires/junctions. Also update used_designators in Power_bank_PCB.kicad_pro. Files changed: Hardware/PCB/Power_bank_PCB/Power_bank_PCB.kicad_sch and Power_bank_PCB.kicad_pro. These edits place the new components and adjust wiring to connect them in the schematic.
    [Power_bank_PCB.kicad_sch]
2026-09-02 Update PCB schematic: add TPS61022 & INA219
    Introduce TPS61022 boost-converter symbol and replace the LTC3525 entry with an INA219 energy/current-sense symbol (value, footprint and datasheet updated). Swap/rename several parts (FET -> DMP3099L), add global power symbols (+3.3V, +5V, VBUS, GND, Vbat), testpoints and discrete components (R24, R27, R16, R19, C10u, D4), and reorganize many wires/junctions and component positions. Also update Power_bank_PCB.kicad_pro used_designators to reflect added/renamed components. These changes align schematic symbols, footprints and net connections with the updated design.
    [Power_bank_PCB.kicad_sch]
2026-09-02 Adjust schematic positions
    Mass-update schematic component and net coordinates to match revised layout (many junctions, wires, labels and symbol positions changed). Add a +3.3V power symbol instance (#PWR064) and update used_designators (R21-29, D3-5, #PWR54-64, etc.). These changes align the schematic with the updated PCB placement and nets.
    [Power_bank_PCB.kicad_sch]
2026-09-02 KiCad schematic: add parts, adjust layout
    Update Power_bank_PCB KiCad project and schematic. Changes include: update used_designators; add/position new symbols (C28, C29, R28, R29, Q4 and several power symbols / #PWR entries); add multiple junctions and wires; relabel text (Fotopanel_enable → Fotopanel_disable, add Foto_raw labels); adjust component values/placements (R18 10k→100k, MCP4018 value refined); move USB connector J2 and update related coordinates. Mostly coordinate/layout and net wiring edits to reflect new parts and routing.
    [Power_bank_PCB.kicad_sch]
2026-09-02 Fixed cold-start issue
    [Power_bank_PCB.kicad_sch]
2026-09-04 First attempt to do PCB layout
    done basic concept without main DC/DC converters
    [Power_bank_PCB.kicad_pcb, Power_bank_PCB.kicad_sch]
2026-09-04 First layout without traces
    [Power_bank_PCB.kicad_pcb, Power_bank_PCB.kicad_sch]
2026-09-06 Positioned modules on PCB and created zones
    [Power_bank_PCB.kicad_pcb, Power_bank_PCB.kicad_sch]
2026-09-06 Generic PCB layout done,
    need some polish and fix minor 25+ DRC errors
    [Power_bank_PCB.kicad_pcb]
2026-09-09 Update of PCB layout
    moved battery state resistors close to STM32
    [Power_bank_PCB.kicad_pcb]
2026-09-09 Further layout update
    Minor fixes
    [Power_bank_PCB.kicad_pcb]
2026-09-09 Solved minor DRC warnings
    [Power_bank_PCB.kicad_pcb]
2026-09-09 Added missing SLT files and added logos
    [Power_bank_PCB.kicad_pcb, Power_bank_PCB.kicad_sch, TPS61022RWUR.stp]
2026-09-09 Delete Hardware/PCB/Power_bank_PCB/~Power_bank_PCB.kicad_sch.lck
    missclicked
2026-09-09 Delete Hardware/PCB/Power_bank_PCB/~Power_bank_PCB.kicad_pcb.lck
    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
2026-09-11 Add main PCB board image
    This commit adds the main PCB design image under Hardware/PCB/Main.png for reference and documentation.
2026-09-11 Added PCB render
2026-09-16 Added PCB BOM
    Added the generated PCB BOM spreadsheet and adjusted KiCad project field visibility so DNP, exclusion, and datasheet columns are hidden from BOM exports. This keeps the design files aligned with the finalized PCB documentation.
    [PCB_BOM.xlsx]
2026-09-17 PCB BOM update
    [PCB_BOM.xlsx]
2026-09-17 Update BOM
    The project BOM was updated to use the new BOM.xlsx file, and the old PCB_BOM.xlsx was removed. The generated Power_bank_PCB.csv under Hardware/PCB/Power_bank_PCB was also added to .gitignore so exported artifacts are not tracked in the repository.
    [BOM.xlsx, PCB_BOM.xlsx]
2026-09-19 First snapshot of solarbank case
    [BOM.xlsx, Battery_prop.ipt, Bottom.ipt, Main.iam, PCB.ipt]
2026-09-19 SolarBank housing is almost ready
    Need to add heat-set threads holes
    [BOM.xlsx, Bottom.ipt, Main.iam, Micro_Button_6x6.STEP, Micro_Button_6x6.ipt, OscarML_Led 3mm Rojo v1.ipt, OscarML_Led 3mm Rojo v1.step, OscarML_Led 3mm Verde.ipt]
2026-09-20 finishing touches to the housing
    [92000A022_Passivated 18-8 Stainless Steel Pan Head Phillips Screws.STEP, 92000A022_Passivated 18-8 Stainless Steel Pan Head Phillips Screws.ipt, 94459A767_Heat-Set Inserts for Plastic.STEP, 94459A767_Heat-Set Inserts for Plastic.ipt, BOM.xlsx, Bottom.ipt, Bottom.stl, Main.iam]
2026-10-09 Add TME BOM and hardware photos
    This commit adds the TME purchase list for the project BOM and includes the hardware documentation photos and soldering videos captured during the build process.
2026-10-11 Enable STM32 flashing and simplify LED loop
    This change adds a custom CMake flash target that uses STM32CubeProgrammer CLI when available, along with VS Code configuration for building and flashing the STM32 target. It also updates the main firmware loop to use a faster LED blink pattern and temporarily disables the INA219 power-check logic while leaving the panel-enable gate commented out.
2026-10-12 Tune INA219 calibration and startup logic
    Adjust the INA219 calibration range to 32V/1A and add a startup sequence plus panel power check loop. The firmware now retries INA219 initialization, reads solar panel power, and enables or disables the panel based on a 0.5 W threshold while blinking status LEDs during startup.
2026-10-15 Add MCP401x I2C potentiometer support
    Add an MCP401x driver with resistance-to-wiper-step conversion and register it in the build. Initialize the potentiometer to 10 kΩ at startup, temporarily disable INA219 initialization, and update panel power conversion to watts.
2026-10-18 Handle button interrupts and harden INA219 I/O
    Validate INA219 inputs and I2C operations, use the configured device address and 16V/400mA calibration, and handle the user button through EXTI to toggle the status LED.
2026-10-19 Add solar charging control and battery display
    Add periodic panel power monitoring, threshold-based panel enablement, and resistance adjustment for MPPT. Show battery charge level on the status LEDs when the user button is pressed, handle USB input events, and ignore local VS Code settings.
2026-10-20 Add USB-aware panel charging control
    Poll USB state to prioritize USB charging, and add panel voltage checks, retry timing, and low-power shutdown before MPPT operation. Update battery status indication and ADC configuration, and calibrate the INA219 for the 0.05-ohm shunt.
