Wudker/Solarbank/(notices)

Notices in the files:
Software/Solar_bank/Core/Inc/main.h:
Copyright (c) 2026 STMicroelectronics.
All rights reserved.
This software is licensed under terms that can be found in the LICENSE file
